tfateba/tbot/README.md

# tbot
tbot is a self balancing robot made to have fun while learning concepts of several disciplines.
