tfateba/tbot/soft/doc/list.md

# INERTIAL UNIT
```sh
# Infos
- ITG/MPU
- GY-521
- InvenSense
- MPU6050
- https://www.robot-maker.com/shop/blog/28_Decouverte-centrale-inertielle-MPU-6050.html
```
# MCU BOARD
```sh
# Infos:
- SainSmart
- Mega 2560
- https://fr.rs-online.com/web/p/arduino/7154084
- https://content.arduino.cc/assets/Pinout-Mega2560rev3_latest.pdf
```

# MOTOR DRIVERS
```sh
# Infos:
- ALFS-TECH.taobao.com
- Wingxine
- miniIBT
https://www.amazon.fr/MiniIBT-Module-dentra%C3%AEnement-moteur-puissants/dp/B01M5CWER4
```

# SWITCH
```sh
# Infos
- APEM2-C2
https://fr.rs-online.com/web/p/interrupteurs-a-levier/3779658
```

# Metal Gearmotor
```sh
# Infos
- Motors
- Encoders
https://www.robotgear.com.au/Product.aspx/Discontinued/489-100-1-Metal-Gearmotor-37Dx52L-mm-with-64-CPR-Encoder
```

# BUZZER
```sh
# Infos
https://fr.rs-online.com/web/p/buzzers-piezo/7716910
```

# Battery
```sh
# Infos
- 11.1v 15c 220mAh Li-Polymer
- https://www.1001hobbies.fr/batteries-et-chargeurs-lipoli-ion/138540-walkera-2000qrx350pro-14-batterie-lipo-11-1v-5200mah-15c.html
```
