tfateba/tbot/soft/doc/wirings.md

# TBOT HARDWARE WIRING :

```sh
UNO / NUCLEO                    MEGA                            MPU5060
 --------------                  --------------                  ------------
|              |                |              |                |            |
|              |                |              |         5V ----| VCC        |
|              |                |              |                |            |
|              |                |              |         GND ---| GND        |
|              |                |              |                |            |
|     D19(PC5) |--------------->|     D21(PD0) |--------------->| SCL        |
|              |                |              |                |            |
|     D18(PC4) |<-------------->|     D20(PD1) |<-------------->| SDA        |
|              |                |              |                |            |
|              |                |              |         NC ----| XDA        |
|              |                |              |                |            |
|              |                |              |         NC ----| XCL        |
|              |                |              |                |            |
|              |                |              |         NC ----| ADO        |
|              |                |              |                |            |
|              |                |              |         NC ----| INT        |
|              |                |              |                 ------------
|              |                |              |
|              |                |              |                MOTOR DRIVER L                        MOTOR L
|              |                |              |                 ---------------------------           ------------
|              |                |              |                |                           |         |            |
|              |                |              |         NC ----| B+                 MOTOR+ |-------->| MOTOR+     |
|              |                |              |                |                           |         |            |
|              |                |              |         GND ---| GND                MOTOR- |-------->| MOTOR-     |
|              |                |              |                |                           |         |            |
|     D12(PB4) |--------------->|     D12(PB6) |--------------->| EN                        |          ------------
|              |                |              |                |                           |
|      D2(PD2) |--------------->|      D2(PE4) |--------------->| RPWM                      |
|              |                |              |                |                           |         BATTERY
|      D3(PD3) |--------------->|      D3(PE5) |--------------->| LPWM                      |          ------------
|              |                |              |                |                           |         |            |
|              |                |              |         NC ----| CT                        |-------->| VBAT+      |
|              |                |              |                |                           |         |            |
|              |                |              |         NC ----| VT                        |-------->| GND        |
|              |                |              |                |                           |         |            |
|              |                |              |                 ---------------------------           ------------
|              |                |              |
|              |                |              |                MOTOR DRIVER R                        MOTOR R
|              |                |              |                 ---------------------------           ------------
|              |                |              |                |                           |         |            |
|              |                |              |         NC ----| B+                        |-------->| MOTOR+     |
|              |                |              |                |                           |         |            |
|              |                |              |         GND ---| GND                       |-------->| MOTOR-     |
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
|              |                |              |                |            |
|      D0(PD0) |<---------------|      D0(PE0) |<---------------| TXD        |
|              |                |              |                |            |
|              |                |              |         GND ---| GND        |
|              |                |              |                |            |
|              |                |              |         5V ----| VCC        |
|              |                |              |                |            |
|              |                |              |--------------->| EN         |
|              |                |              |                |            |
 --------------                  --------------                  ------------
UNO / NUCLEO                    MEGA

```
