tfateba/tbot/hard/PCBA/schematic.pdf

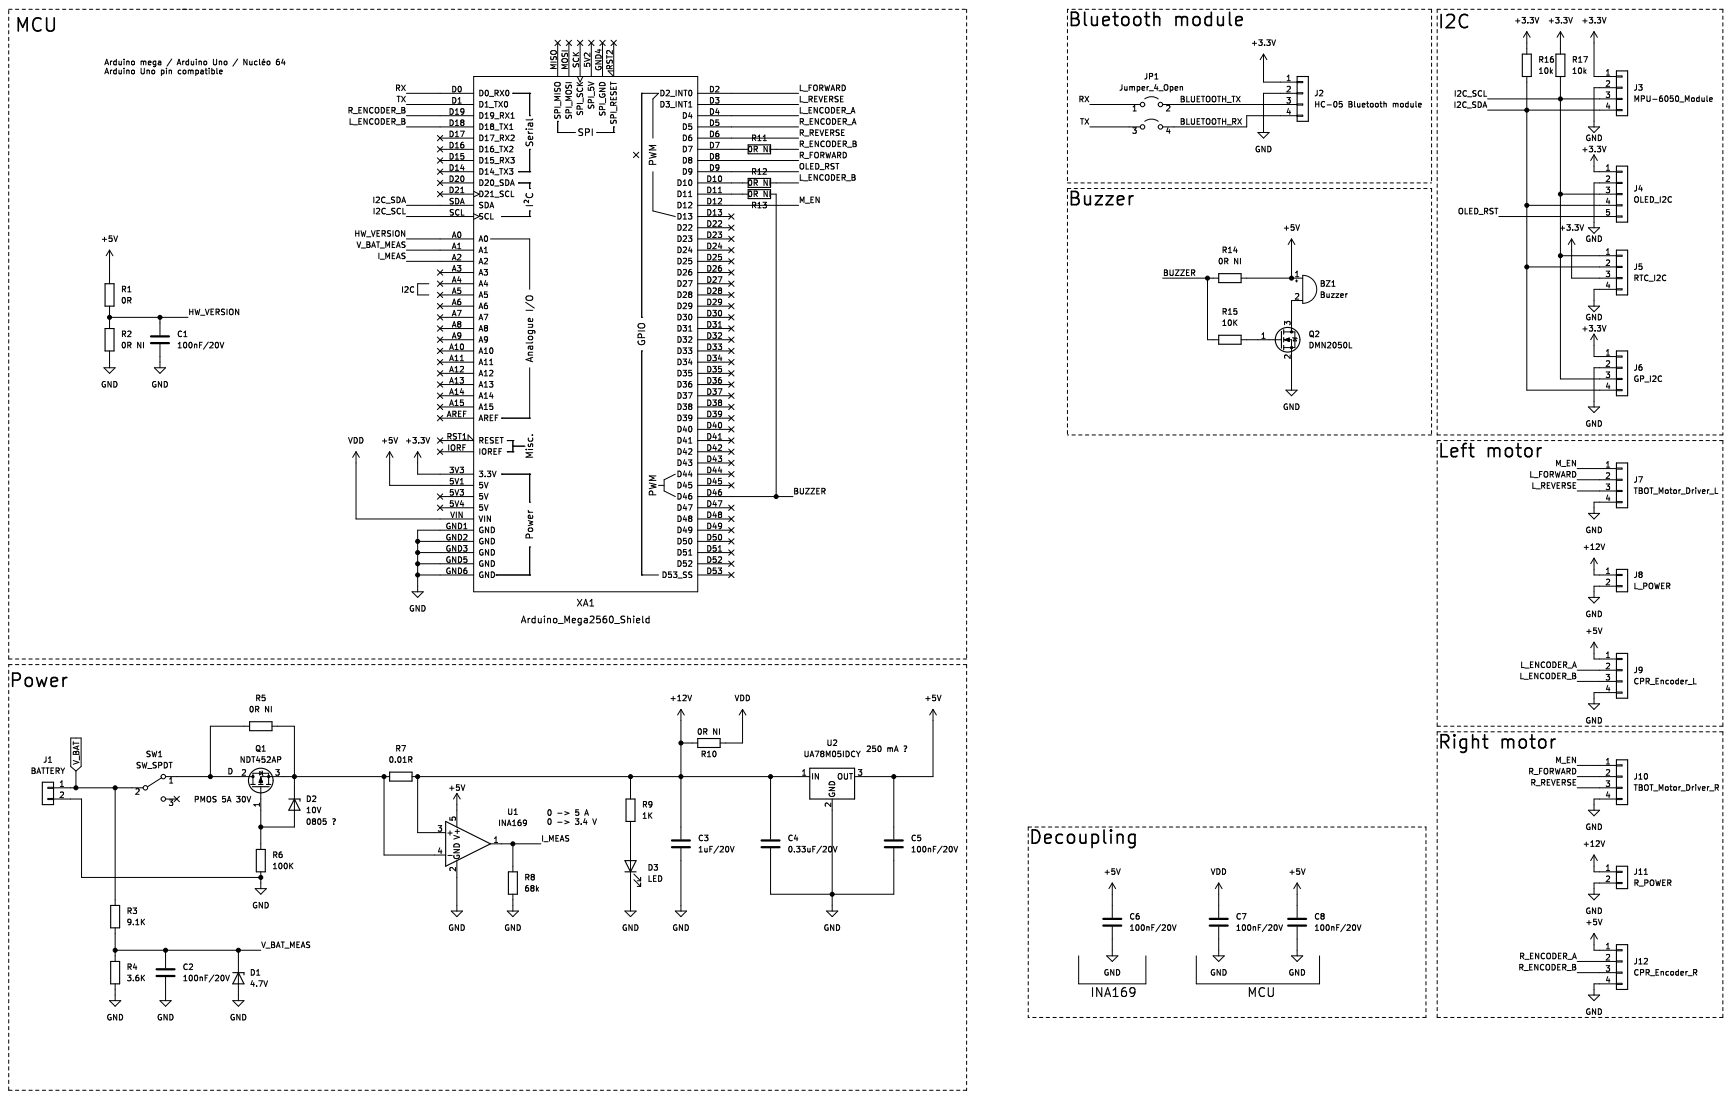
[picture p1: page 1]
