tfateba/tbot/hard/PCBA/TOP.pdf

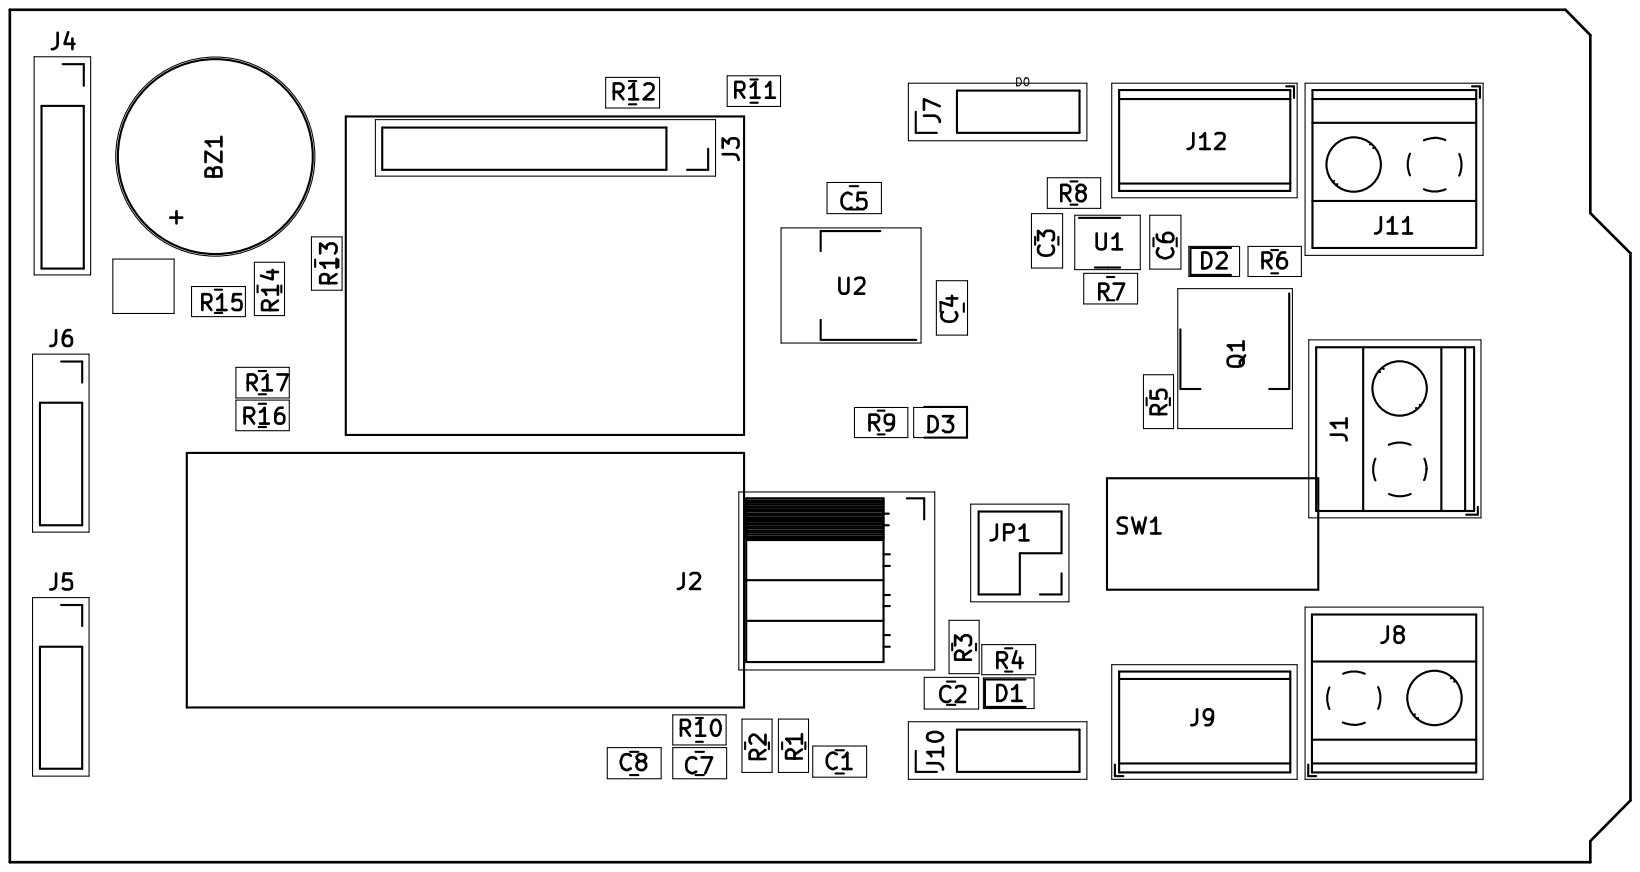
[picture p2: page 1]
