tfateba/tbot/hard/TBOT.kicad_pcb

## KiCad design hard/TBOT.kicad_pcb (2023-04-23)

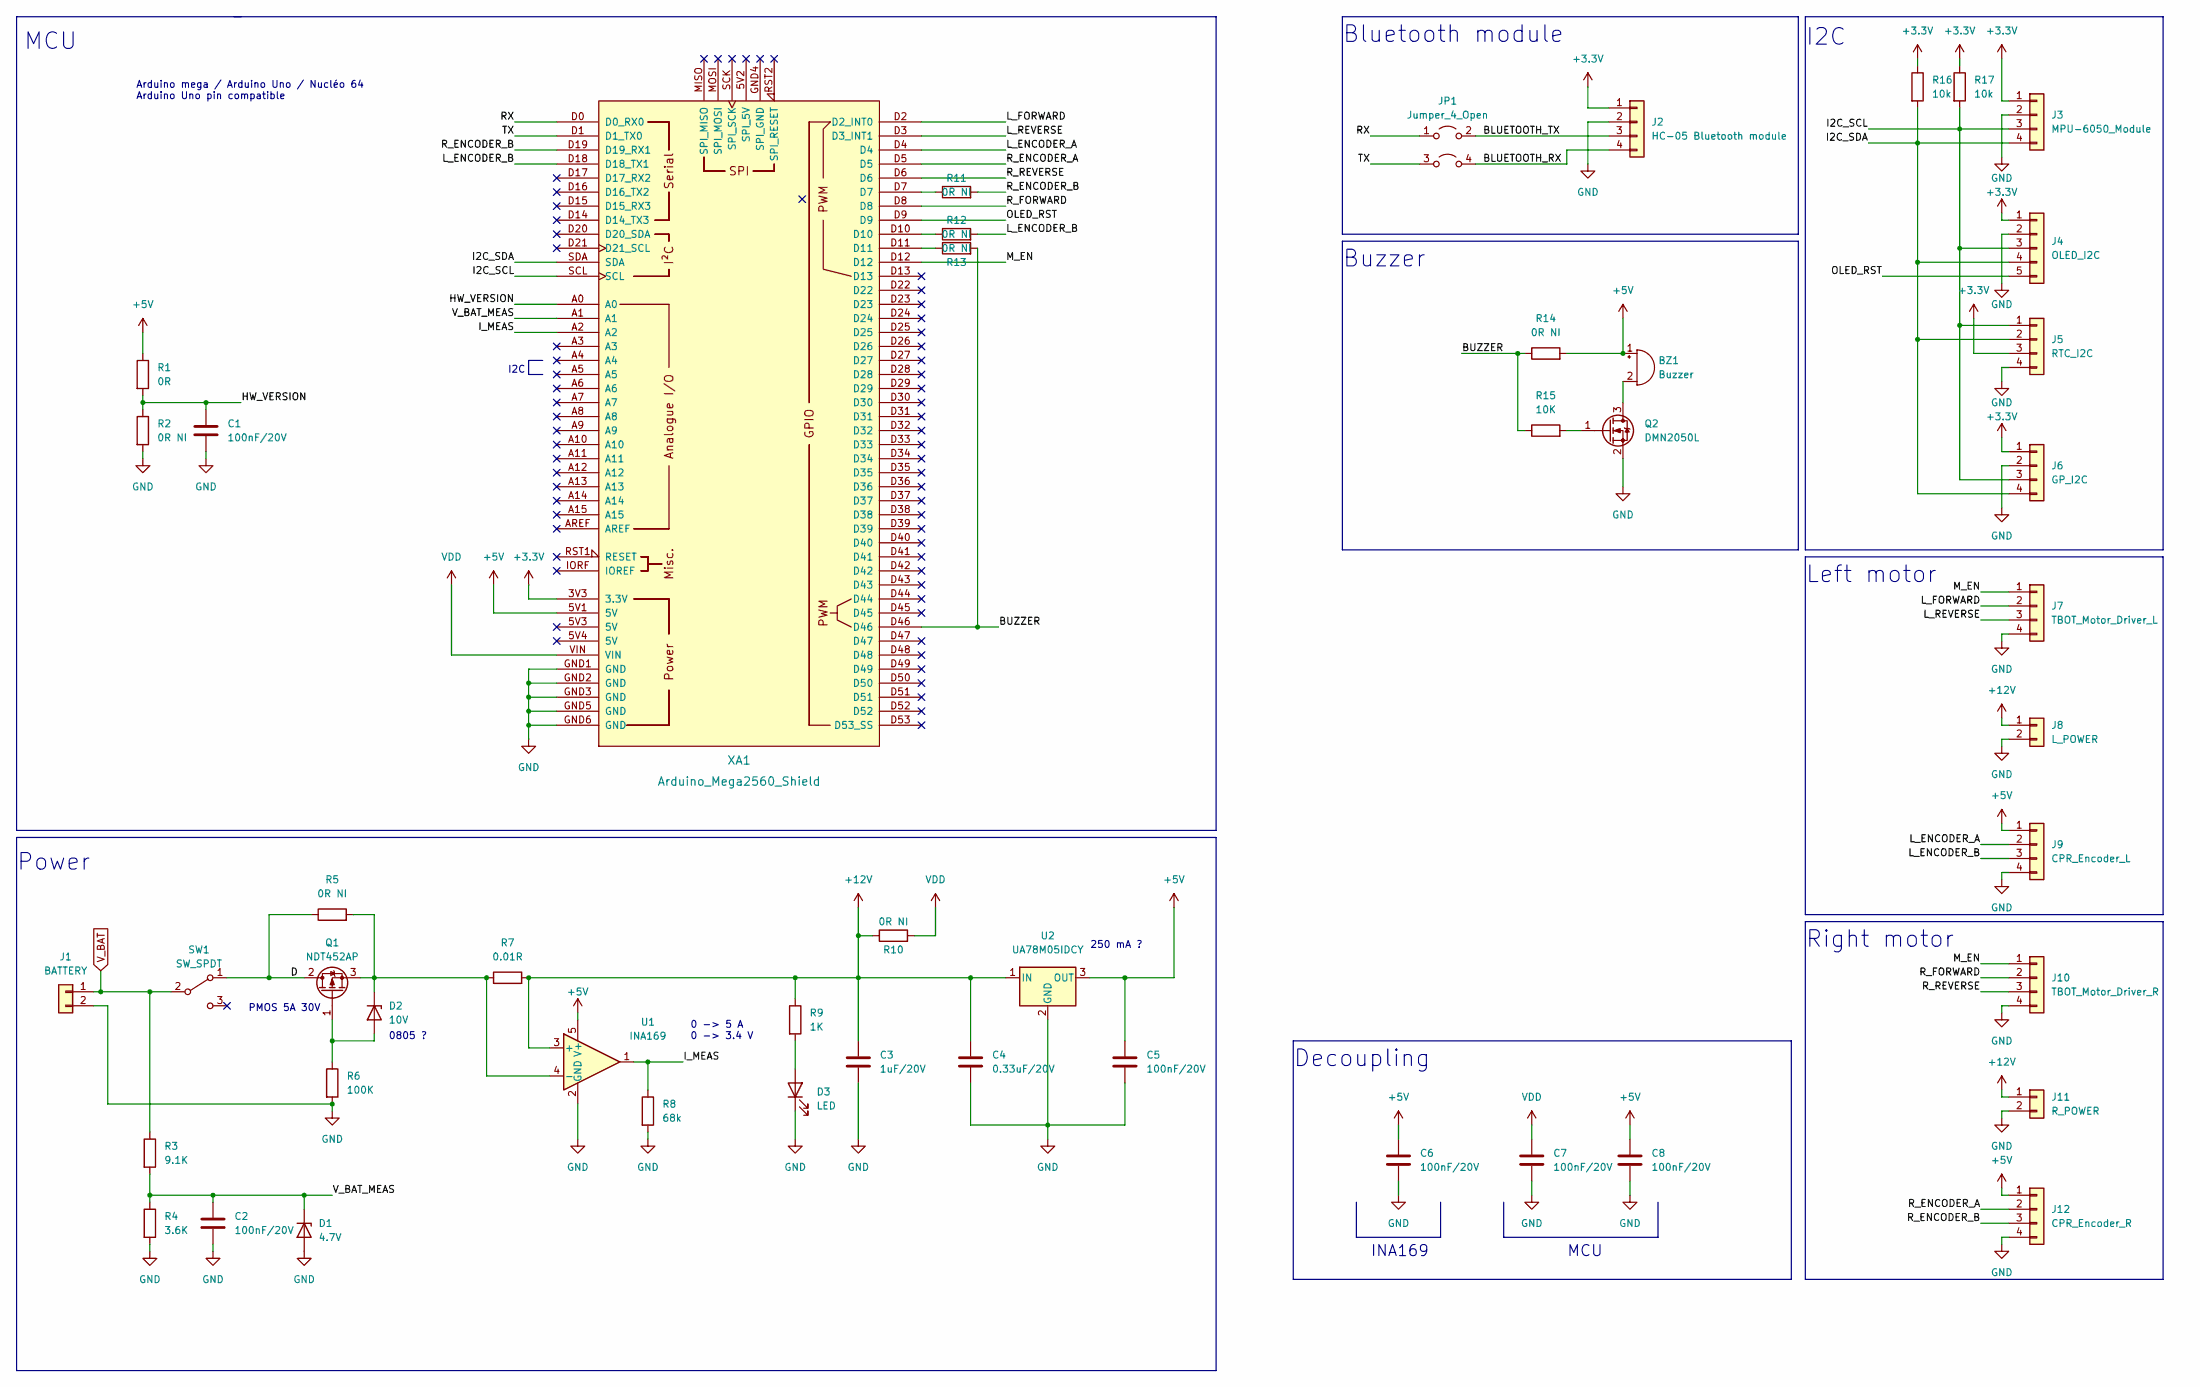
[picture p3: schematic TBOT.kicad_sch, TBOT main module board]

Parts:
BZ1: Buzzer; Buzzer_12x9.5RM7.6
C1, C2, C5, C6, C7, C8: 100nF/20V; C_0805_2012Metric
C3: 1uF/20V; C_0805_2012Metric
C4: 0.33uF/20V; C_0805_2012Metric
D1: 4.7V; D_SOD-323
D2: 10V; D_SOD-323
D3: LED; LED_0805_2012Metric
J1: BATTERY; TerminalBlock_Phoenix_MKDS-1,5-2-5.08_1x02_P5.08mm_Horizont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
J2: HC-05 Bluetooth module; PinSocket_1x04_P2.54mm_Horizontal
J3: MPU-6050_Module
J4: OLED_I2C; PinSocket_1x05_P2.54mm_Vertical
J5: RTC_I2C; PinSocket_1x04_P2.54mm_Vertical
J6: GP_I2C; PinSocket_1x04_P2.54mm_Vertical
J7: TBOT_Motor_Driver_L; PinHeader_1x04_P2.54mm_Vertical
J8: L_POWER; TerminalBlock_Phoenix_MKDS-1,5-2-5.08_1x02_P5.08mm_Horizont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
J9: CPR_Encoder_L; TerminalBlock_Phoenix_MPT-0,5-4-2.54_1x04_P2.54mm_Horizontal
J10: TBOT_Motor_Driver_R; PinHeader_1x04_P2.54mm_Vertical
J11: R_POWER; TerminalBlock_Phoenix_MKDS-1,5-2-5.08_1x02_P5.08mm_Horizont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
J12: CPR_Encoder_R; TerminalBlock_Phoenix_MPT-0,5-4-2.54_1x04_P2.54mm_Horizontal
JP1: Jumper_4_Open; PinHeader_2x02_P2.54mm_Vertical
Q1: NDT452AP; SOT-223-3_TabPin2
Q2: DMN2050L; SOT-23
R1: 0R; R_0805_2012Metric
R2, R5, R10, R11, R12, R13, R14: 0R NI; R_0805_2012Metric
R3: 9.1K; R_0805_2012Metric
R4: 3.6K; R_0805_2012Metric
R6: 100K; R_0805_2012Metric
R7: 0.01R; R_0805_2012Metric
R8: 68k; R_0805_2012Metric
R9: 1K; R_0805_2012Metric
R15: 10K; R_0805_2012Metric
R16, R17: 10k; R_0805_2012Metric
SW1: SW_SPDT; 5638A
U1: INA169; SOT-23-5
U2: UA78M05IDCY; SOT-223
XA1: Arduino_Mega2560_Shield

Connections:
+3.3V: J2.1, J3.1, J4.1, J5.3, J6.1, R16.1, R17.1, XA1.3V3 (3.3V)
+5V: BZ1.1 (-), C5.1, C6.1, C8.1, J9.1, J12.1, R1.1, R14.2, U1.5 (V+), U2.3 (OUT), XA1.5V1 (5V)
+12V: C3.1, C4.1, J8.1, J11.1, R7.2, R9.1, R10.1, U1.3 (+), U2.1 (IN)
/BLUETOOTH_RX: J2.4, JP1.4 (D)
/BLUETOOTH_TX: J2.3, JP1.2 (B)
/BUZZER: R13.2, R14.1, R15.1, XA1.D46
/D: Q1.2 (D), R5.1, SW1.1 (A)
/HW_VERSION: C1.1, R1.2, R2.1, XA1.A0
/I2C_SCL: J3.3, J4.3, J5.1, J6.3, R17.2, XA1.SCL
/I2C_SDA: J3.4, J4.4, J5.2, J6.4, R16.2, XA1.SDA
/I_MEAS: R8.1, U1.1, XA1.A2
/L_ENCODER_A: J9.2, XA1.D4
/L_ENCODER_B: J9.3, R12.2, XA1.D18 (D18_TX1)
/L_FORWARD: J7.2, XA1.D2 (D2_INT0)
/L_REVERSE: J7.3, XA1.D3 (D3_INT1)
/M_EN: J7.1, J10.1, XA1.D12
/OLED_RST: J4.5, XA1.D9
/RX: JP1.1 (A), XA1.D0 (D0_RX0)
/R_ENCODER_A: J12.2, XA1.D5
/R_ENCODER_B: J12.3, R11.2, XA1.D19 (D19_RX1)
/R_FORWARD: J10.2, XA1.D8
/R_REVERSE: J10.3, XA1.D6
/TX: JP1.3 (C), XA1.D1 (D1_TX0)
/V_BAT_MEAS: C2.1, D1.1 (K), R3.2, R4.1, XA1.A1
GND: C1.2, C2.2, C3.2, C4.2, C5.2, C6.2, C7.2, C8.2, D1.2 (A), D3.1 (K), J1.2, J2.2, J3.2, J4.2, J5.4, J6.2, J7.4, J8.2, J9.4, J10.4, J11.2, J12.4, Q2.2 (S), R2.2, R4.2, R6.2, R8.2, U1.2 (GND), U2.2 (GND), XA1.GND1 (GND), XA1.GND2 (GND), XA1.GND3 (GND), XA1.GND5 (GND), XA1.GND6 (GND)
unnamed: BZ1.2 (+), Q2.3 (D)
unnamed: D2.1 (K), Q1.3 (S), R5.2, R7.1, U1.4 (-)
unnamed: D2.2 (A), Q1.1 (G), R6.1
unnamed: D3.2 (A), R9.2
unnamed: R11.1, XA1.D7
unnamed: R12.1, XA1.D10
unnamed: R13.1, XA1.D11
unnamed: Q2.1 (G), R15.2
VDD: C7.1, R10.2, XA1.VIN
V_BAT: J1.1, R3.1, SW1.2 (B)

Notes on the sheet:
250 mA ?
INA169
MCU
Right motor
0 -> 5 A 0 -> 3.4 V
Bluetooth module
Decoupling
Arduino mega / Arduino Uno / Nucléo 64 Arduino Uno pin compatible
I2C
Buzzer
0805 ?
I2C
Left motor
Power
PMOS 5A 30V

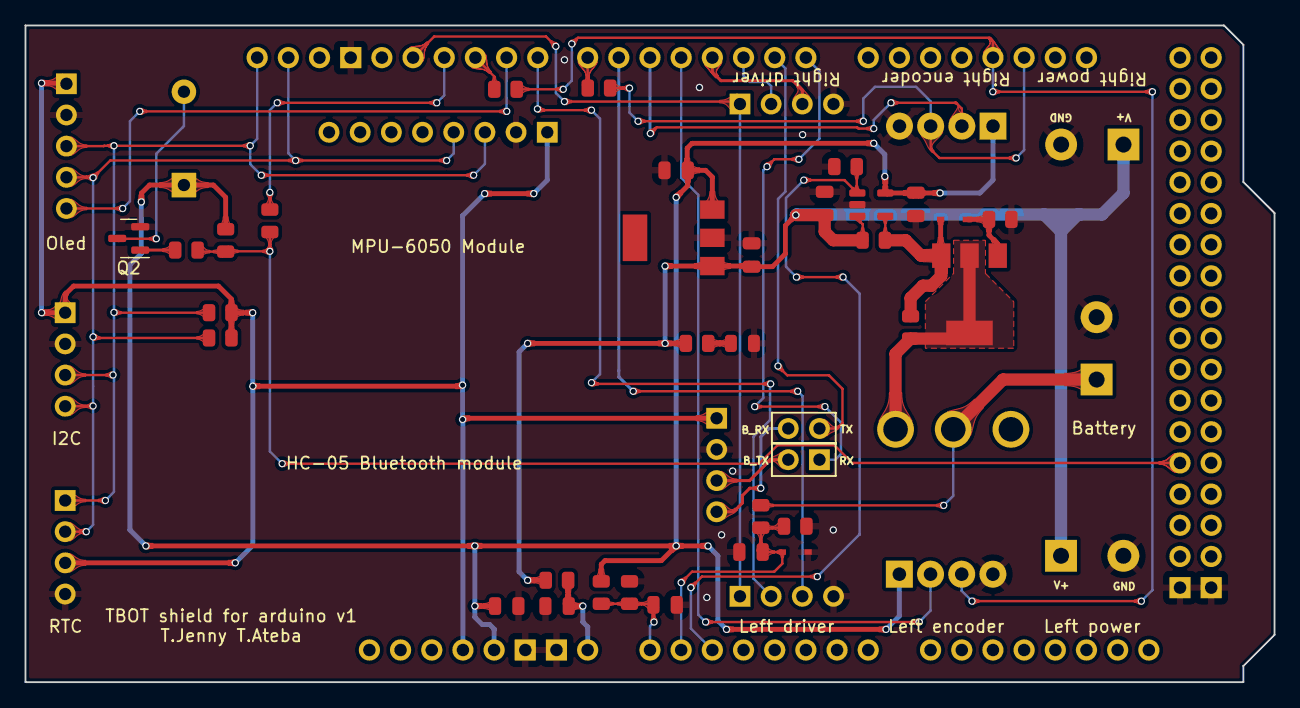
[picture p4: board TBOT.kicad_pcb from above]

Board: 2 copper layers, 101.8 x 53.5 mm, 48 parts (0 on the bottom side), 35 nets.
