tfateba/tbot/soft/src/kalman.c

/*
    TBOT - 2015...2021 Theodore Ateba
    This Kalman filter was inspired from the following:

    Copyright (C) 2012 Kristian Lauszus, TKJ Electronics. All rights reserved.

    This software may be distributed and modified under the terms of the GNU
    General Public License version 2 (GPL2) as published by the Free Software
    Foundation and appearing in the file GPL2.TXT included in the packaging of
    this file. Please note that GPL2 Section 2[b] requires that all works based
    on this software must also be made publicly available under the terms of
    the GPL2 ("Copyleft").

    Contact information
    -------------------

    Kristian Lauszus, TKJ Electronics
    Web      :  http://www.tkjelectronics.com
    e-mail   :  kristianl@tkjelectronics.com
*/

/**
 * @file    kalman.c
 * @brief   Kalman filter source file.
 *
 * @addtogroup KALMAN
 * @{
 */

/*==========================================================================*/
/* Global variables.                                                        */
/*==========================================================================*/

float Q_angle;   /**< Process noise variance for the accelerometer.         */
float Q_bias;    /**< Process noise variance for the gyro bias.             */
float R_measure; /**< The variance of the measurement noise.                */

float angle;     /**< The angle calculated by the Kalman filter.            */
float bias;      /**< The gyro bias calculated by the Kalman filter.        */
float rate;      /**< Unbiased rate calculated from the rate and the
                       calculated bias.                                     */

float P[2][2];   /**< Error covariance matrix.                              */
float K[2];      /**< Kalman gain.                                          */
float y;         /**< Angle difference.                                     */
float S;         /**< Estimate error.                                       */

/*==========================================================================*/
/* Functions.                                                               */
/*==========================================================================*/

/**
 * @brief  Initialize the Kalman filter.
 */
void kalmanInit(void) {

  /* We will set the variables like so, these can also be tuned by the user */
  Q_angle   = 0.001;
  Q_bias    = 0.003;
  R_measure = 100;
  angle     = 0;      /* Reset the angle. */
  bias      = 0;      /* Reset bias.      */

  /*
   * Since we assume that the bias is 0 and we know the starting
   * angle (use setAngle), the error covariance matrix is set like so see:
   * http://en.wikipedia.org/wiki/Kalman_filter#
   * Example_application.2C_technical
   */
  P[0][0] = 0;
  P[0][1] = 0;
  P[1][0] = 0;
  P[1][1] = 0;
};

/**
 * @brief   Calcul the estimate angle by using the kalman filter.
 *
 * @note    The angle should be in degrees.
 * @note    The rate should be in degrees per second.
 * @note    The delta time should be in seconds.
 *
 * @param[in] newAngle  current angle mesured by the IMU
 * @param[in] newRate   current angle rate mesured by the IMU
 * @param[in] dt        time between tow angles measurement
 *
 * @return    angle     the result of the kalman filter computing
 */
float kalmanGetAngle(float newAngle, float newRate, float dt) {

  /*
   * KasBot V2  -  Kalman filter module - http://www.x-firm.com/?page_id=145
   * Modified by Kristian Lauszus
   * Modified by Theodore Ateba
   */

  /* Step 1 */
  rate = newRate - bias;
  angle += dt * rate;

  /* Update estimation error covariance - Project the error covariance ahead */
  /* Step 2 */
  P[0][0] += dt * (dt*P[1][1] - P[0][1] - P[1][0] + Q_angle);
  P[0][1] -= dt * P[1][1];
  P[1][0] -= dt * P[1][1];
  P[1][1] += Q_bias * dt;

  /* Discrete Kalman filter measurement update equations
   * - Measurement Update ("Correct")
   * Calculate Kalman gain - Compute the Kalman gain
   */

  /* Step 4 */
  S = P[0][0] + R_measure;

  /* Step 5 */
  K[0] = P[0][0] / S;
  K[1] = P[1][0] / S;

  /* Calculate angle and bias. */
  /* Update estimate with measurement zk (newAngle) */
  /* Step 3 */
  y = newAngle - angle;

  /* Step 6 */
  angle += K[0] * y;
  bias += K[1] * y;

  /* Calculate estimation error covariance - Update the error covariance */
  /* Step 7 */
  P[0][0] -= K[0] * P[0][0];
  P[0][1] -= K[0] * P[0][1];
  P[1][0] -= K[1] * P[0][0];
  P[1][1] -= K[1] * P[0][1];

  return angle;
}

/**
 * @brief   Set the angle, this should be set as the starting angle.
 *
 * @param[in] newAngle  Set kalman filter starting angle
 */
void setAngle(float newAngle) {

  angle = newAngle;
}

/**
 * @brief   Read the rate of the angle.
 *
 * @return  rate  the unbiased angle rate
 */
float kalmanGetRate(void) {

  return rate;
}

/**
 * @brief   Tune the kalman filter by setting the angle.
 *
 * @param[in] newQ_angle  angle used to tune the Kalman filter
 */
void kalmanSetQangle(float newQ_angle) {

  Q_angle = newQ_angle;
}

/**
 * @brief   Tune the kalman filter by setting the bias.
 *
 * @param[in] newQ_bias   bias angle used to set the Kalman filter
 */
void kalmanSetQbias(float newQ_bias) {

  Q_bias = newQ_bias;
}

/**
 * @brief   set the variance of the measured noise.
 *
 * @param[in] newR_measure  variance of the measurement noise value
 */
void kalmanSetRmeasure(float newR_measure) {

  R_measure = newR_measure;
}

/**
 * @brief   Read the process noise variance for the gyro bias.
 *
 * @return  Q_angle process noise variance for the gyro bias
 */
float kalmanGetQangle(void) {

  return Q_angle;
}

/**
 * @brief   Read the process noise variance for the accelerometer.
 *
 * @return  Q_bias  process noise variance for the accelerometer
 */
float kalmanGetQbias(void) {

  return Q_bias;
}

/**
 * @brief   Read the process noise variance for the gyro bias.
 *
 * @return  R_measure   process noise variance for the gyro bias
 */
float kalmanGetRmeasure(void) {

  return R_measure;
}

/** @} */
