tfateba/tbot/(commit log)

2016-09-14 clean the project, build and fix the git for commit
    [halconf.h, main.c]
2016-11-08 add asserv files, ext and motor files.
2016-11-08 Activate the ADC and EXT modules
2016-11-08 Add MCU support for ADC and Timers for PWM generation.
2016-11-08 Correct the idents of kalman filter.
2016-11-08 Implement the motors to work under ChibiOS.
2016-11-08 Reimplementation of the PID.
2016-11-08 Desactivate the pwm demo function.
2016-11-12 Correct the code style for the robot
    [ip_motor.c]
2016-11-12 Correct the files ident and code stytle.
    [ip_mpu6050.c]
2016-11-12 Correct the code style
    [ip_pwm.c]
2016-11-15 Remove the arduino commented functions.
2016-11-15 Correct the PWM output pins.
    [ip_pwm.c]
2016-11-15 remove space in i2c files.
2016-11-17 Correct the indint of the files ip_asserv.*
    [ip_asserv.c, ip_asserv.h]
2016-11-17 Change the comment, correct the indent.
    [ip_motor.c]
2016-11-18 Disable the ADC configuration because it is not used.
2016-12-04 Change the Serial Speed and activate the ADC driver
2016-12-04 Add ADC configuration to the project.
2016-12-04 Correct pid motor calcul and remove the arduino IDE function.
2016-12-05 Reimplement the motor robot file.
2016-12-05 Correct the delta value.
    [ip_asserv.c, ip_asserv.h]
2016-12-05 Add A0 reading ADC tu tune PID for the robot asservissement.
2016-12-05 Remove the compilation warning about pwmSetPulseWidtch implicit declaration
2016-12-05 Remove mothor velocity asservissement.
2016-12-05 Ajust the kalman filter for the robot.
2016-12-05 Set the correctors parameters.
    [main.c]
2016-12-05 Tunning of PID
2016-12-05 Remove the ADC features.
2017-01-04 Update PWM functions headers.
2017-01-04 Correct the file to respect ChibiOS code style.
    [main.c]
2017-07-29 Add a function to set the pwm duty cycle.
2017-07-29 Correct comment and ident.
    [ip_mpu6050.c]
2017-07-29 Function reimplementation and rename, correct some comment.
    [ip_motor.c]
2017-07-29 Modify the Makefile to program the Arduino Mega 2560 board.
2017-07-31 Resolve the warning: implicit declaration of function.
    [ip_motor.c]
2017-08-28 Clean the PWM header file.
2017-08-28 Clean the PWM source file and add a function to set the duty cycle.
2017-08-28 Clean the PID header file and rename a function.
2017-08-28 clean the i2c source file.
2017-08-28 Clean the IMU header file.
2017-08-28 Rename some functions and clean the IMU source file.
2017-08-28 Rename function and clean the kalman filter source file.
2017-08-28 Update function prototype and add comment to the kalman filter header file.
2017-08-28 Rename functions, remove the PWM function related and the Encoder source code to this file.
2017-08-28 Update functions prototypes, remove Encoder macros and clean motor header file.
2017-08-28 Add encoder header file.
2017-08-28 Add encoder source file.
2017-08-28 Correct file name in the file header and correct a comment.
    [ip_main.c]
2017-08-28 Remove a trailing space in pwm source file.
2017-08-28 Add pwm macros to the header file.
2017-08-28 Remove PWM macros in the motor header file.
2017-08-28 Correct a comment and indentation in comment.
    [ip_motor.c]
2017-08-28 Add encoders debug messages.
2017-08-28 Cut the comment to be less that 80 caracters.
2017-08-28 Update function prototypes.
2017-08-28 Correct the Merge to ChibiOS trunk.
    [ip_asserv.c, ip_motor.c, ip_mpu6050.c, ip_pwm.c]
2017-09-01 Change the comment to print float value.
2017-09-01 Include the buzzer functionnality to make tone at init time.
    [ip_main.c]
2017-09-01 Activate the lib to print float, add buzzer file to the list of target and correct ident.
2017-10-21 Improve comment of encoder file.
2017-10-21 Rename the encoder header file.
2017-10-25 Add and correct comment on robot pwm header file.
2017-11-17 Add encoder driver structure and enumeration.
2017-11-18 Add a PID driver structure and change the prototype of the pid function.
2017-11-18 Add main file header and modify the asserv function prototype.
2017-11-18 Remove encoder enumeration and add motor driver structure.
2017-11-18 Define mpu6050 driver structure and modify the function prototypes.
2017-11-18 Remove the dependency to the motors and return the pid value.
2017-11-18 Add robot driver, motor control and update asservicement functions.
2017-11-18 Add robot driver instance and update function that need the robot driver pointer.
2017-11-19 Add robot pid controler parameters initialisation.
2017-11-19 Add function to initialise the pid controler parameters fo rasservissement.
2017-11-19 Add the pid initialisation function prototypes.
2018-03-03 Add comment to the pid header file.
2018-03-04 Update source files, correct minor errors and comment.
    [ip_asserv.c, ip_encoder.c, ip_main.c, ip_motor.c, ip_mpu6050.c, ip_pwm.c]
2018-03-04 Remove the cammel case for all functions.
2018-03-14 Correct the head of the source files.
    [ip_main.c, ip_motor.c, ip_mpu6050.c, ip_pwm.c]
2018-03-14 Correct the head of the header files.
    [ip_main.h]
2018-03-14 Rename variable by using cammel case.
2018-03-14 Remove motor function and pid dependancy.
2018-03-14 Remove motor dependency.
2023-01-26 Update logo and debug trace.
2023-01-28 Simplify some driver names.
2023-01-29 Update wiring to have the best compatibility with uno and nucleo boards.
2023-01-29 Add doc file that describe the wiring of the tbot.
2023-01-30 Initial commit for electronic board
    [TBOT.kicad_pcb, TBOT.kicad_sch, power.kicad_sch]
2023-01-31 Update with pcb
    [TBOT.kicad_pcb, TBOT.kicad_sch]
2023-01-31 DRC checked
    [TBOT.kicad_pcb, power.kicad_sch]
2023-02-01 Add jumper for Bluetooth selection
    [TBOT.kicad_pcb, TBOT.kicad_sch]
2023-02-01 Update Motor and pwm files.
2023-04-23 First version of TBOT hardware
    [TBOT.kicad_pcb, TBOT.kicad_sch]
2023-04-24 Add schematic.pdf
